HMS-RIC/PMT-Protector-for-Optical-Stim/README.md

View this project on [CADLAB.io](https://cadlab.io/node/999). 

# PMT-Protector-for-Optical-Stim
Protection circuit that takes a PMT shutter signal and laser stim signal. Shutter is closed when laser stim is on. Laser stim is disabled if shutter hasn't closed yet
