HMS-RIC/PMT-Protector-for-Optical-Stim/PMT Protector For Optical Stim Gamma1a.brd

## EAGLE design PMT Protector For Optical Stim Gamma1a.brd (2018-05-08)

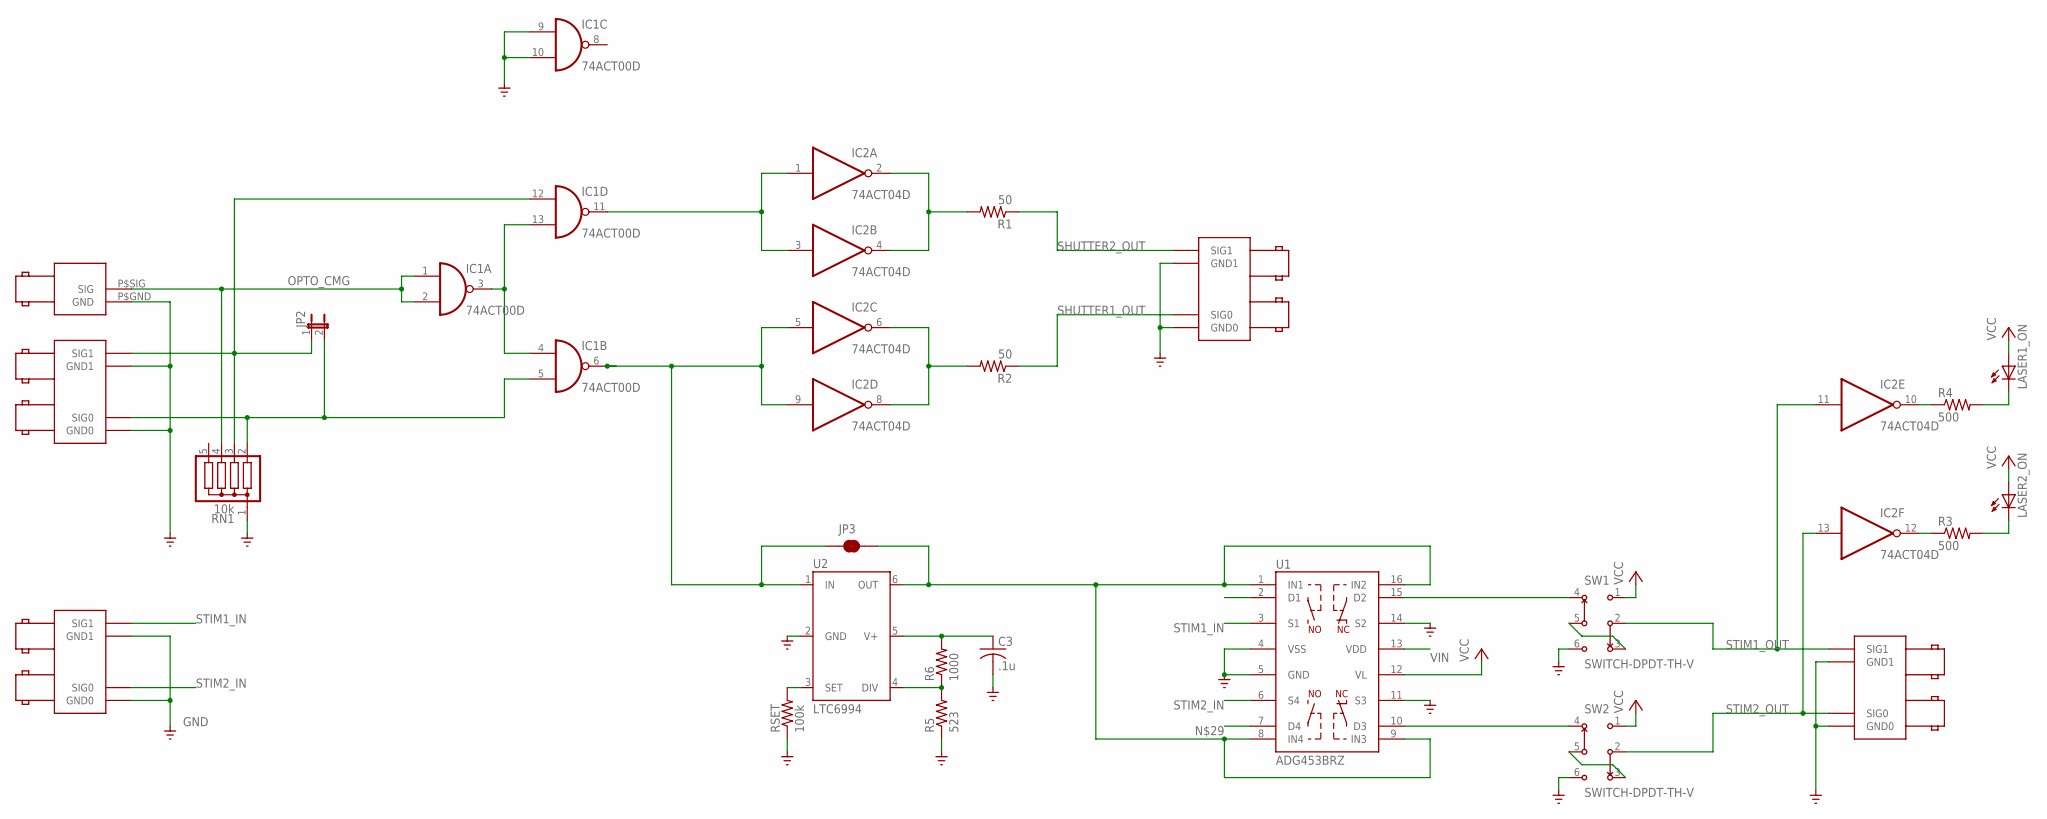
[picture p2: schematic PMT Protector For Optical Stim Gamma1a.sch, sheet 1]

Parts:
C3: .1u; C0805K
IC1: 74ACT00D; SO14
IC2: 74ACT04D; SO14
JP2: JP1E; JP1
JP3: JUMPER-SMT_2_NC_TRACE_SILK; SMT-JUMPER_2_NC_TRACE_SILK
LASER1_ON, LASER2_ON: LED5MM
OPTO_CMG: BNC_RIGHT_ANGLE
R1, R2: 50; R0805
R3, R4: 500; R0805
R5: 523; R0805
R6: 1000; R0805
RN1: 10k; SIL5
RSET: 100k; R0805
SHTR_IN: BNC_RIGHT_ANGLE_DOUBLE
SHTR_OUT: BNC_RIGHT_ANGLE_DOUBLE
STIM_IN: BNC_RIGHT_ANGLE_DOUBLE
STIM_OUT: BNC_RIGHT_ANGLE_DOUBLE
SW1, SW2: SWITCH-DPDT-TH-V; SWITCH-DPDT
U1: ADG453BRZ; SO16
U2: LTC6994; SOT23-6

Connections:
GND: C3.2, IC1.9 (I0), IC1.10 (I1), OPTO_CMG.P$GND (GND), R5.1, RN1.1, RSET.1, SHTR_IN.P$GND0 (GND0), SHTR_IN.P$GND1 (GND1), SHTR_OUT.P$GND0 (GND0), SHTR_OUT.P$GND1 (GND1), STIM_IN.P$GND0 (GND0), STIM_IN.P$GND1 (GND1), STIM_OUT.P$GND0 (GND0), STIM_OUT.P$GND1 (GND1), SW1.6, SW2.6, U1.4 (VSS), U1.5 (GND), U1.11 (S3), U1.14 (S2), U2.2 (GND); also elsewhere on the board
unnamed: IC1.12 (I0), JP2.1, RN1.3, SHTR_IN.P$SIG1 (SIG1)
unnamed: IC2.12 (O), R3.1
unnamed: IC1.6 (O), IC2.5 (I), IC2.9 (I), JP3.1, U2.1 (IN)
unnamed: IC2.2 (O), IC2.4 (O), R1.2
unnamed: IC2.10 (O), R4.1
unnamed: LASER1_ON.K (C), R4.2
unnamed: LASER2_ON.K (C), R3.2
unnamed: SW2.3, SW2.5
unnamed: IC1.11 (O), IC2.1 (I), IC2.3 (I)
unnamed: IC2.6 (O), IC2.8 (O), R2.2
unnamed: IC1.3 (O), IC1.4 (I0), IC1.13 (I1)
unnamed: SW2.4, U1.7 (D4), U1.10 (D3)
unnamed: JP3.2, U1.1 (IN1), U1.8 (IN4), U1.9 (IN3), U1.16 (IN2), U2.6 (OUT)
unnamed: SW1.3, SW1.5
unnamed: SW1.4, U1.2 (D1), U1.15 (D2)
unnamed: R5.2, R6.1, U2.4 (DIV)
unnamed: RSET.2, U2.3 (SET)
OPTO_CMG: IC1.1 (I0), IC1.2 (I1), OPTO_CMG.P$SIG (SIG), RN1.4
SHUTTER1_OUT: R2.1, SHTR_OUT.P$SIG0 (SIG0)
SHUTTER2_OUT: R1.1, SHTR_OUT.P$SIG1 (SIG1)
SHUTTER_IN: IC1.5 (I1), JP2.2, RN1.2, SHTR_IN.P$SIG0 (SIG0)
STIM1_IN: STIM_IN.P$SIG1 (SIG1), U1.3 (S1)
STIM1_OUT: IC2.11 (I), STIM_OUT.P$SIG1 (SIG1), SW1.2
STIM2_IN: STIM_IN.P$SIG0 (SIG0), U1.6 (S4)
STIM2_OUT: IC2.13 (I), STIM_OUT.P$SIG0 (SIG0), SW2.2
VCC: LASER1_ON.A, LASER2_ON.A, SW1.1, SW2.1, U1.12 (VL); also elsewhere on the board
VCC2: C3.1, R6.2, U2.5 (V+)
VIN: U1.13 (VDD); also elsewhere on the board

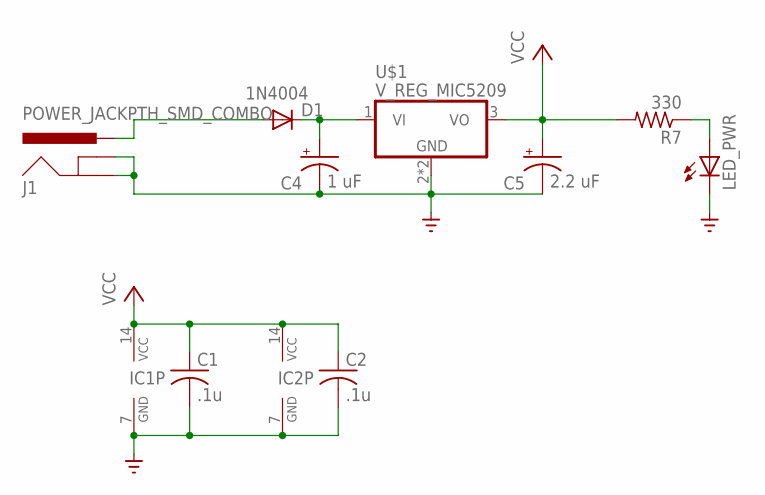
[picture p3: schematic PMT Protector For Optical Stim Gamma1a.sch, sheet 2]

Parts:
C1, C2: .1u; C0805K
C4: 1 uF; E2,5-5
C5: 2.2 uF; E2,5-5
D1: 1N4004; DO41-10
IC1: 74ACT00D; SO14
IC2: 74ACT04D; SO14
J1: POWER_JACKPTH_SMD_COMBO; POWER_JACK_COMBO
LED_PWR: LED5MM
R7: 330; R0805
U$1: V_REG_MIC5209; SOT-223

Connections:
GND: C1.2, C2.2, C4.-, C5.-, IC1.7 (GND), IC2.7 (GND), J1.GND (GNDBREAK), J1.GND@1 (GND), LED_PWR.K (C), U$1.2 (GND), U$1.4 (GND); also elsewhere on the board
unnamed: D1.A, J1.POWER (PWR)
unnamed: LED_PWR.A, R7.1
VCC: C1.1, C2.1, C5.+, IC1.14 (VCC), IC2.14 (VCC), R7.2, U$1.3 (VO); also elsewhere on the board
VIN: C4.+, D1.C, U$1.1 (VI); also elsewhere on the board

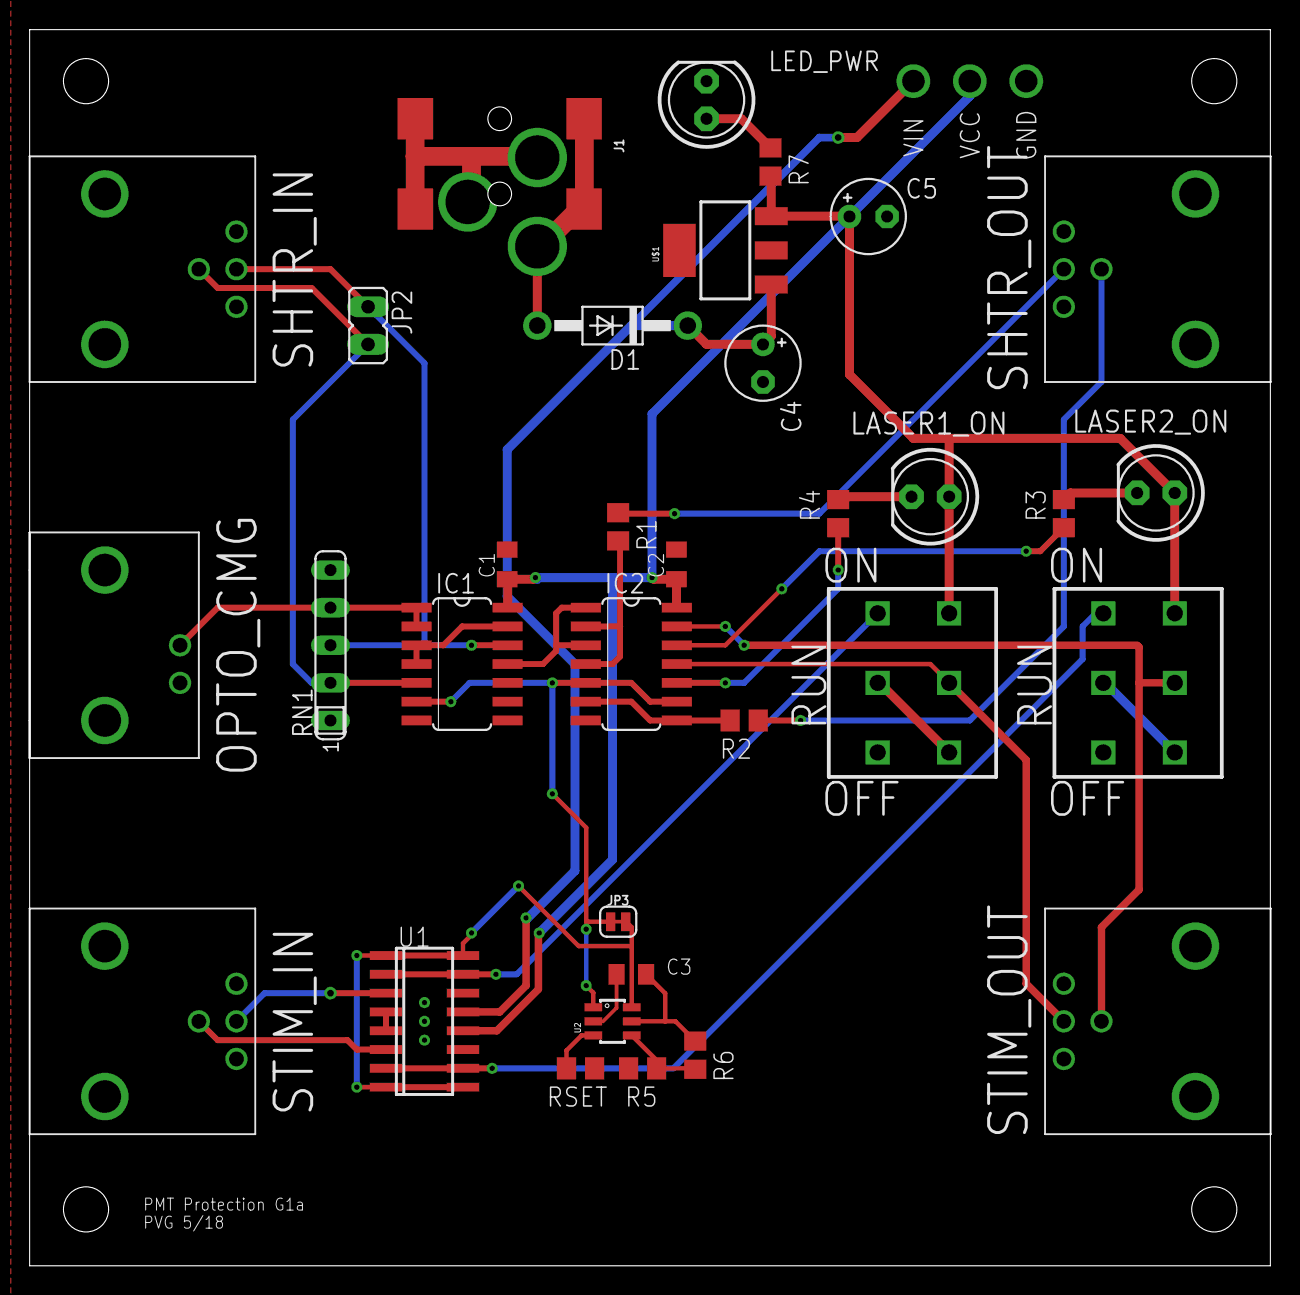
[picture p4: board PMT Protector For Optical Stim Gamma1a.brd from above]

Board: 2 copper layers, 83.8 x 83.5 mm, 33 parts (0 on the bottom side), 31 nets.
